SchematixYouTube/ATtiny85-RCD-Tester/PCB Virtual image.png

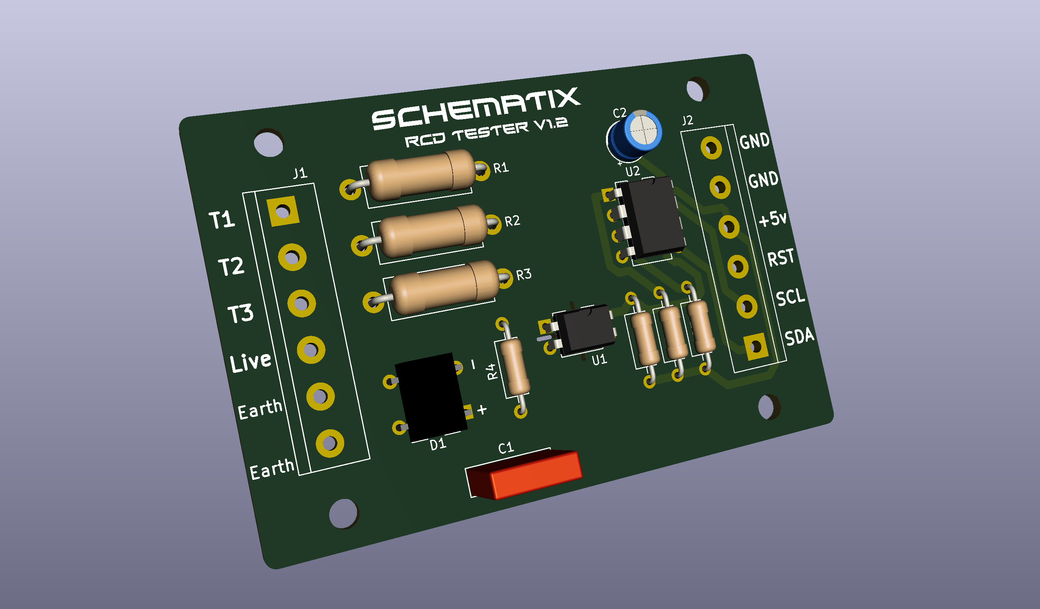
PCB Virtual image.png
