SchematixYouTube/ATtiny85-RCD-Tester/Schematic.pdf

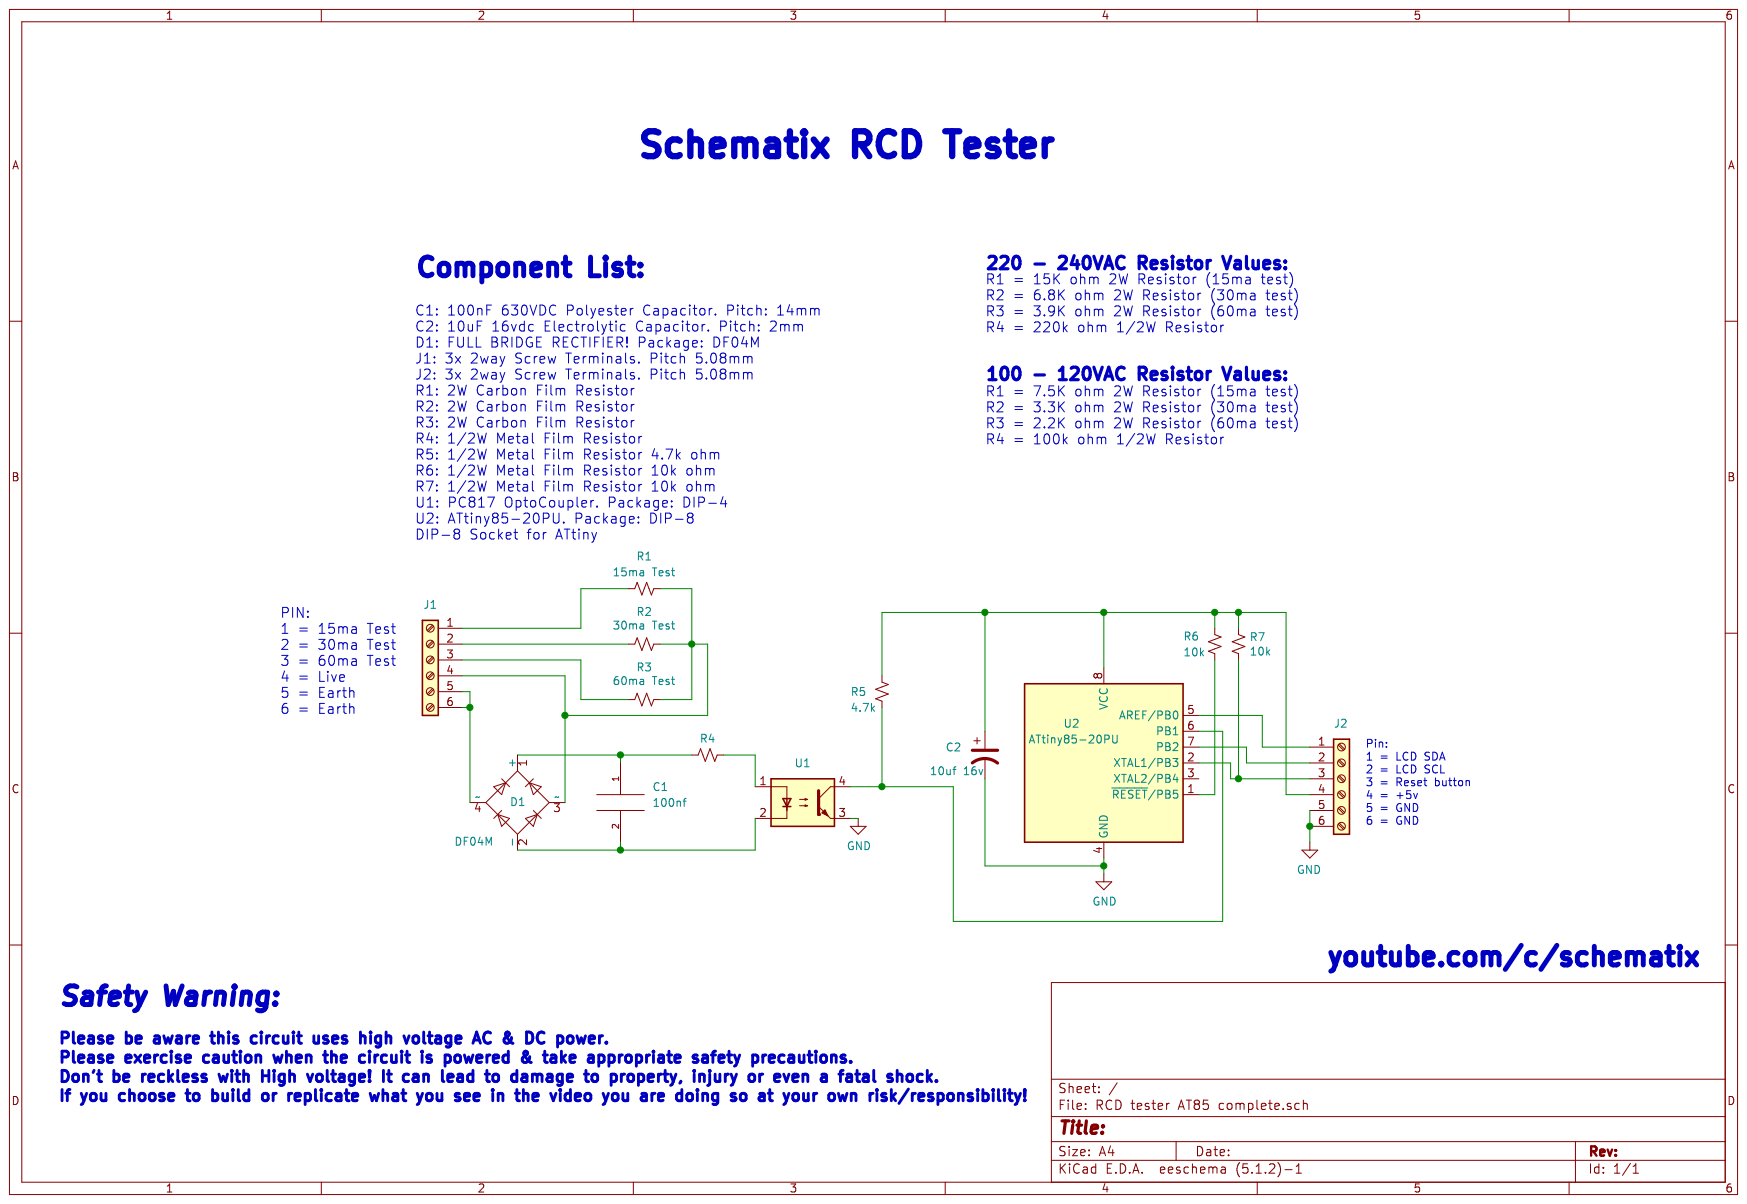
[picture p2: page 1]
