SchematixYouTube/ATtiny85-RCD-Tester/Wiring Diagram.pdf

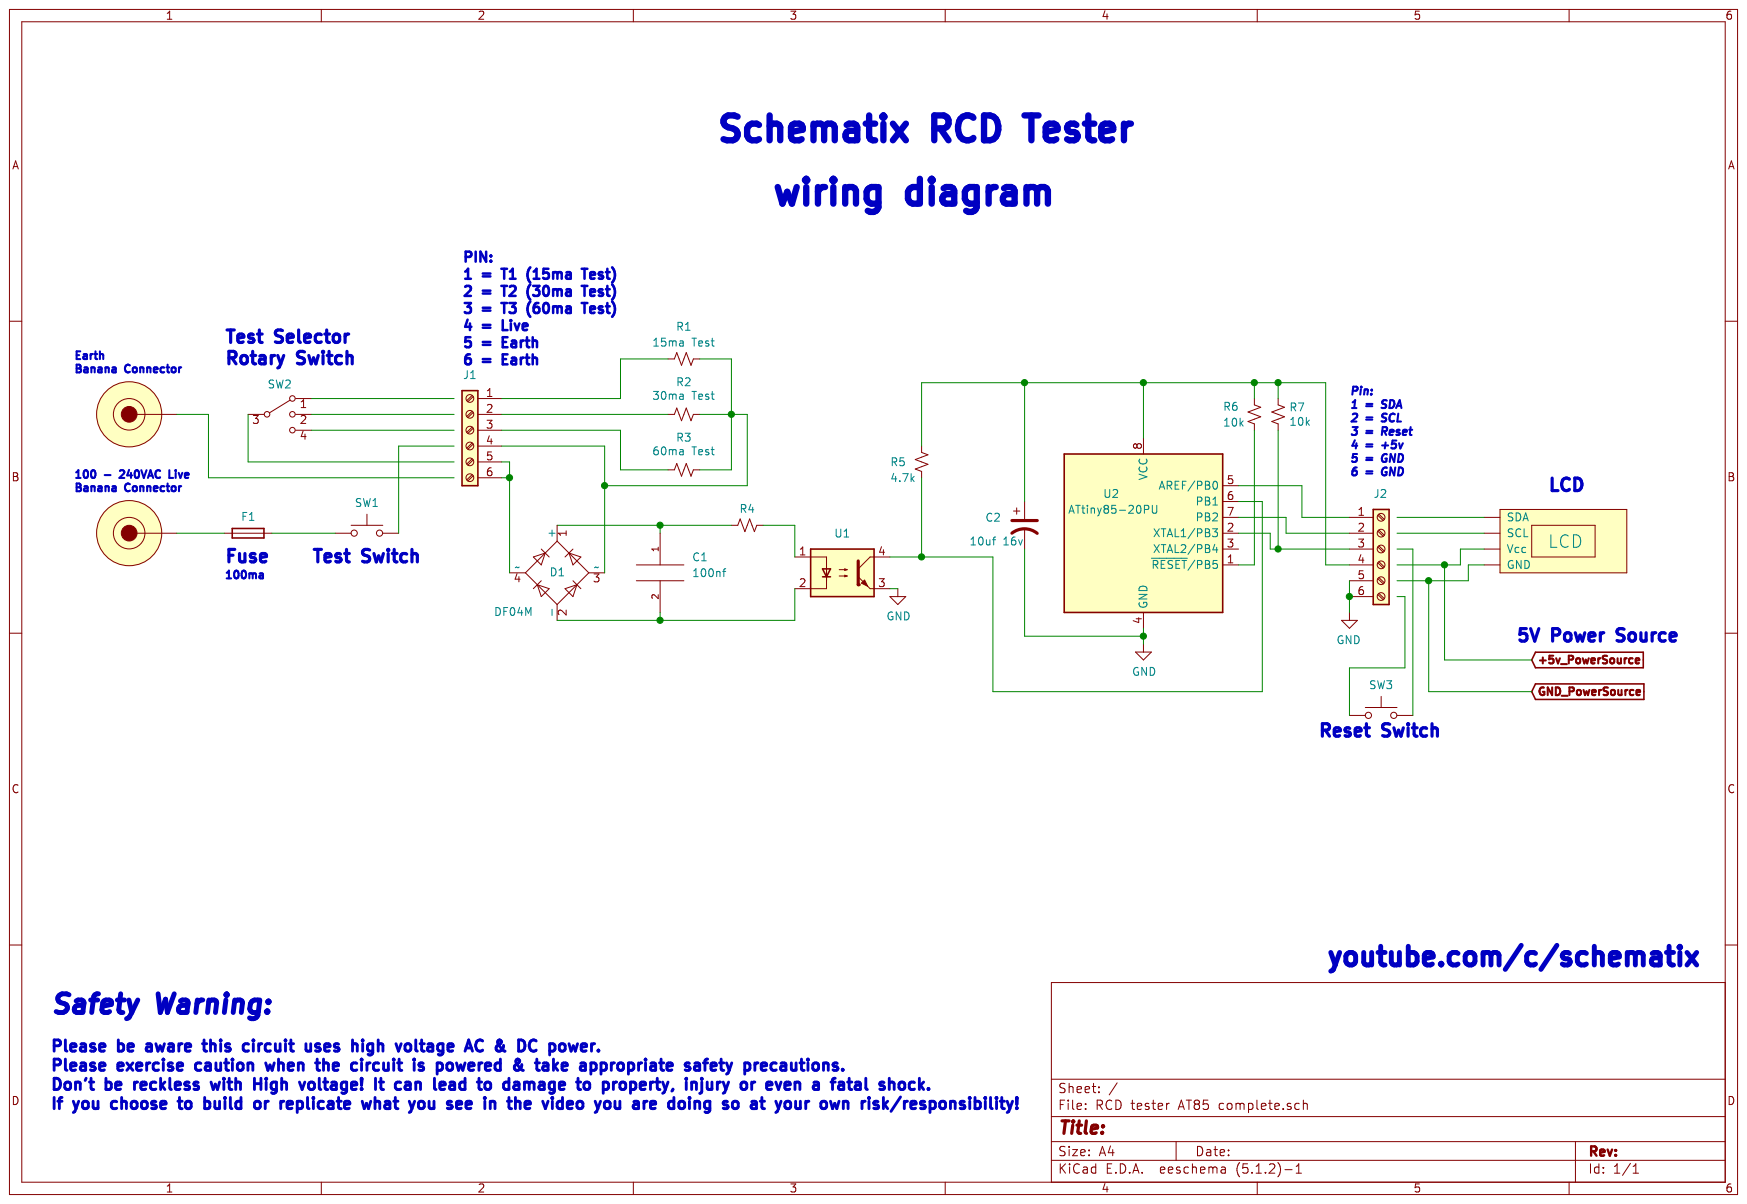
[picture p3: page 1]
